designer-1407/Smart-Muscle/Photos/Smart Muscule 1/manufacturing_wiev.jpg

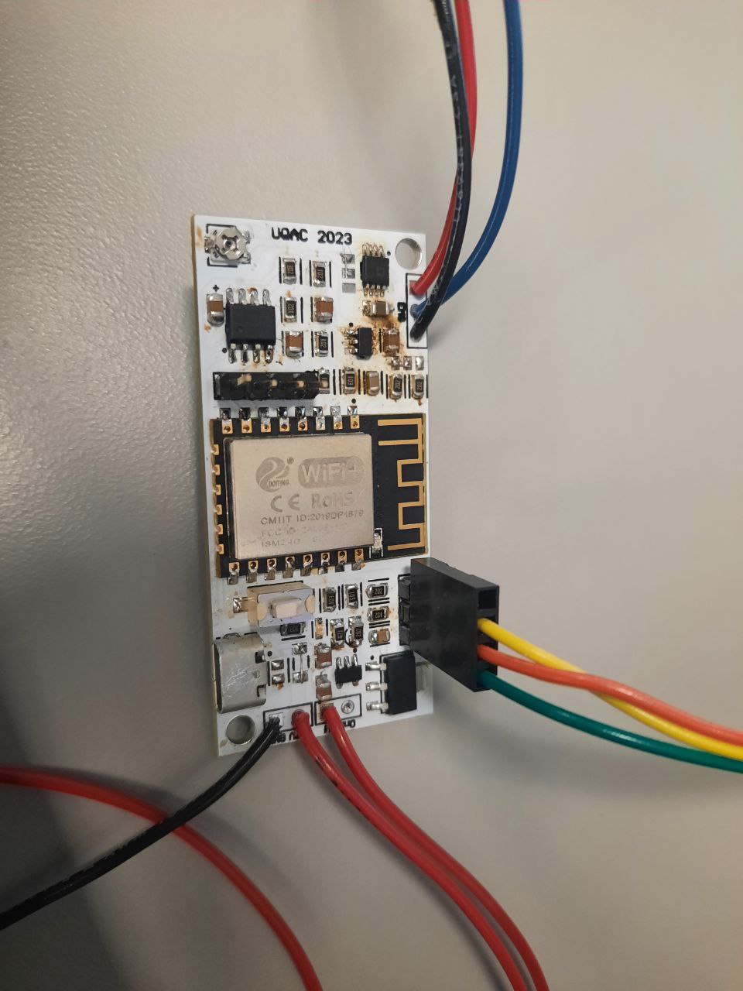
Photos/Smart Muscule 1/manufacturing_wiev.jpg
