designer-1407/Smart-Muscle/Photos/MyoWare Tests/Myoware.jpg

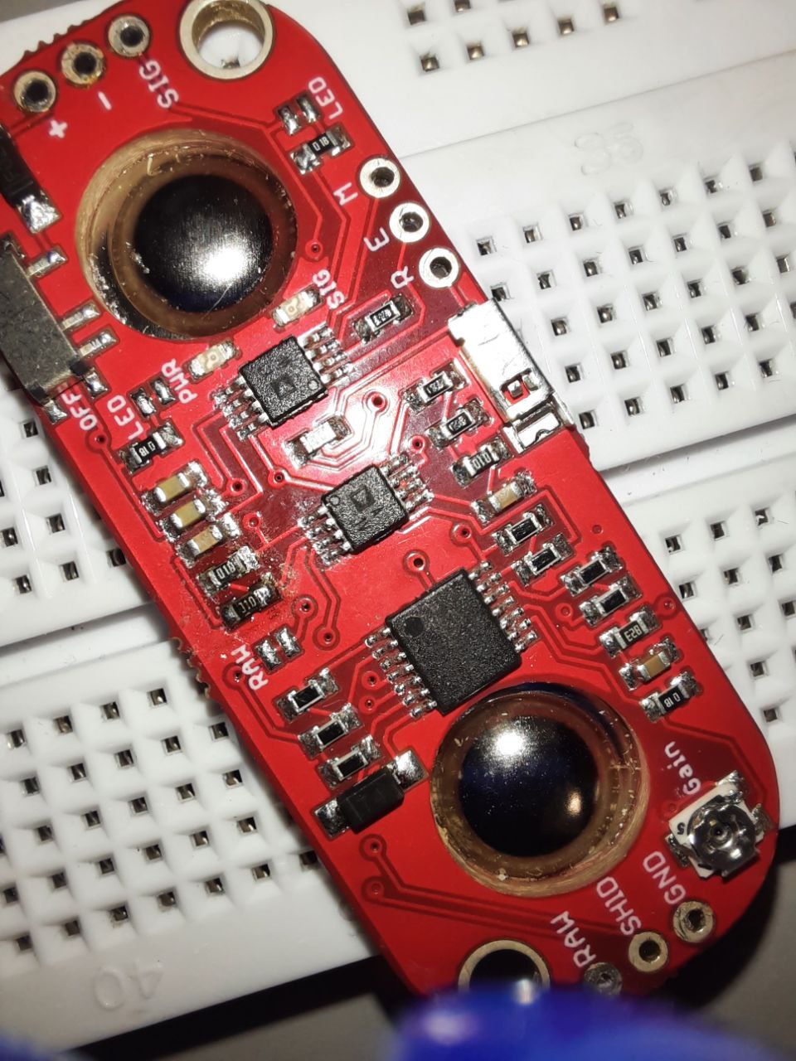
Photos/MyoWare Tests/Myoware.jpg
