designer-1407/Smart-Muscle/README.md

A SYSTEM FOR RECOGNIZING THE POSITION OF FINGERS OF AMPUTATED LIMBS BASED ON EMG SIGNAL AND MACHINE LEARNING
Studio_Project_V4 (1)
