designer-1407/Smart-Muscle/Photos/Smart Muscule 1/smart_muscule_case_1.jpg

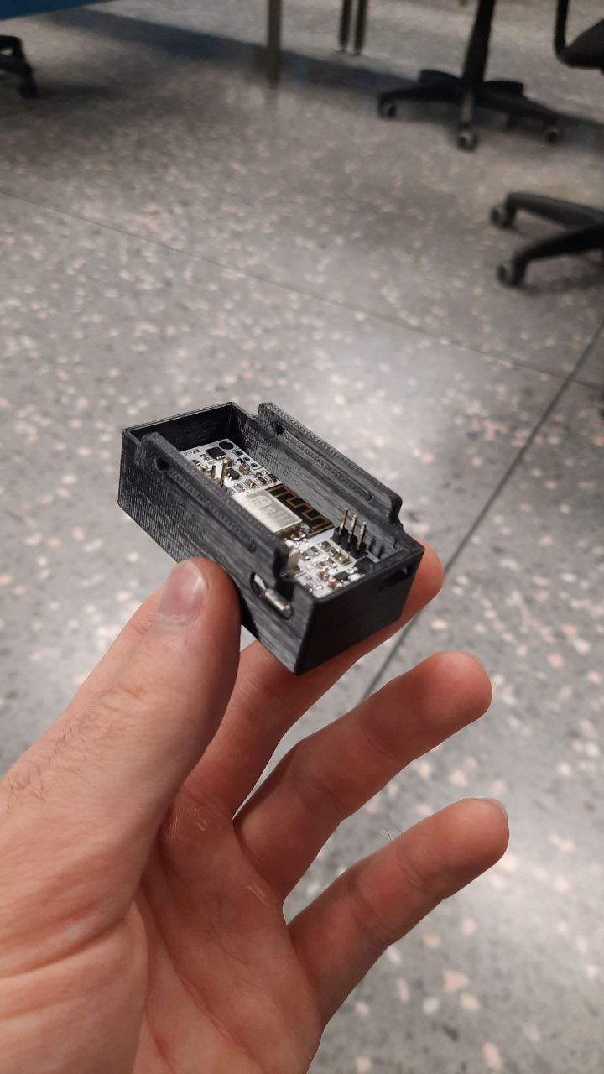
Photos/Smart Muscule 1/smart_muscule_case_1.jpg
