designer-1407/Smart-Muscle/Photos/Smart Muscule 1/smart_muscule_case_3D_wiev_2.jpg

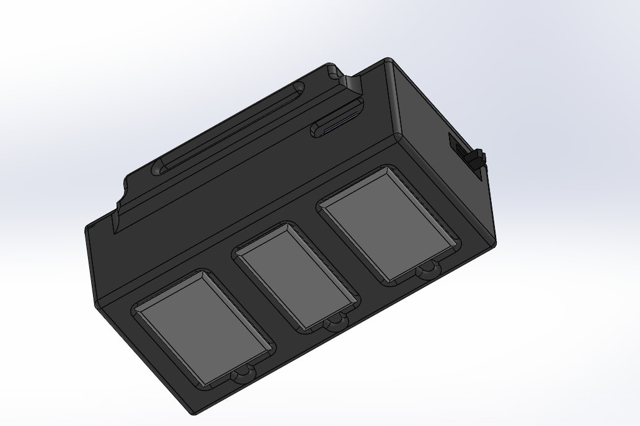
Photos/Smart Muscule 1/smart_muscule_case_3D_wiev_2.jpg
