designer-1407/Smart-Muscle/Photos/Smart Muscule 1/stainless_electrodes.jpg

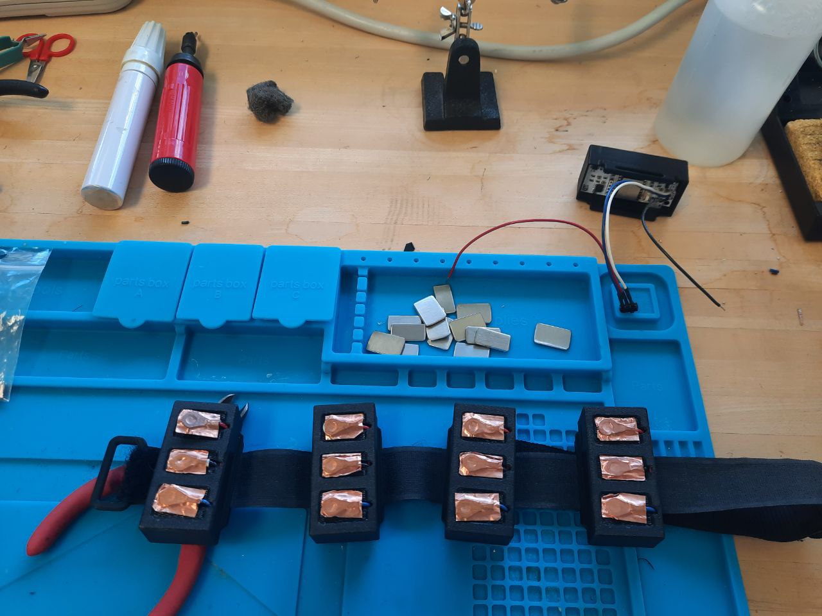
Photos/Smart Muscule 1/stainless_electrodes.jpg
