designer-1407/Smart-Muscle/Photos/Smart Muscule development/mock-up-1.jpg

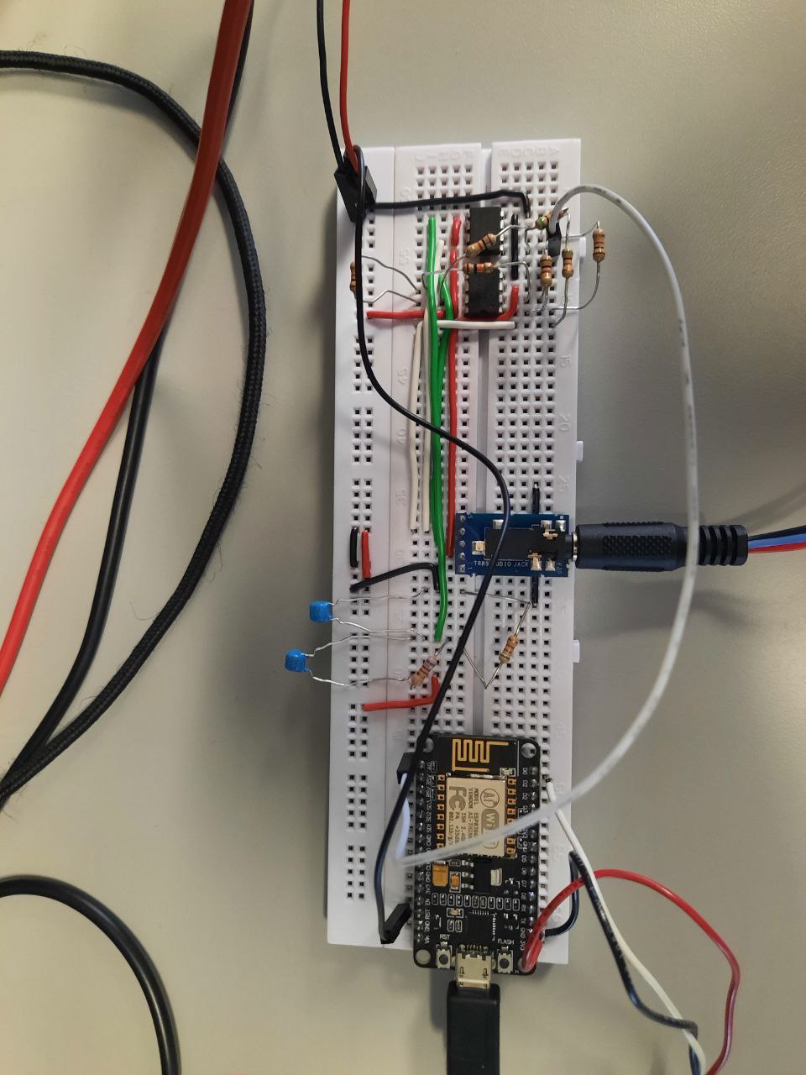
Photos/Smart Muscule development/mock-up-1.jpg
