designer-1407/Smart-Muscle/Scematics/Strct_scenatic.JPG

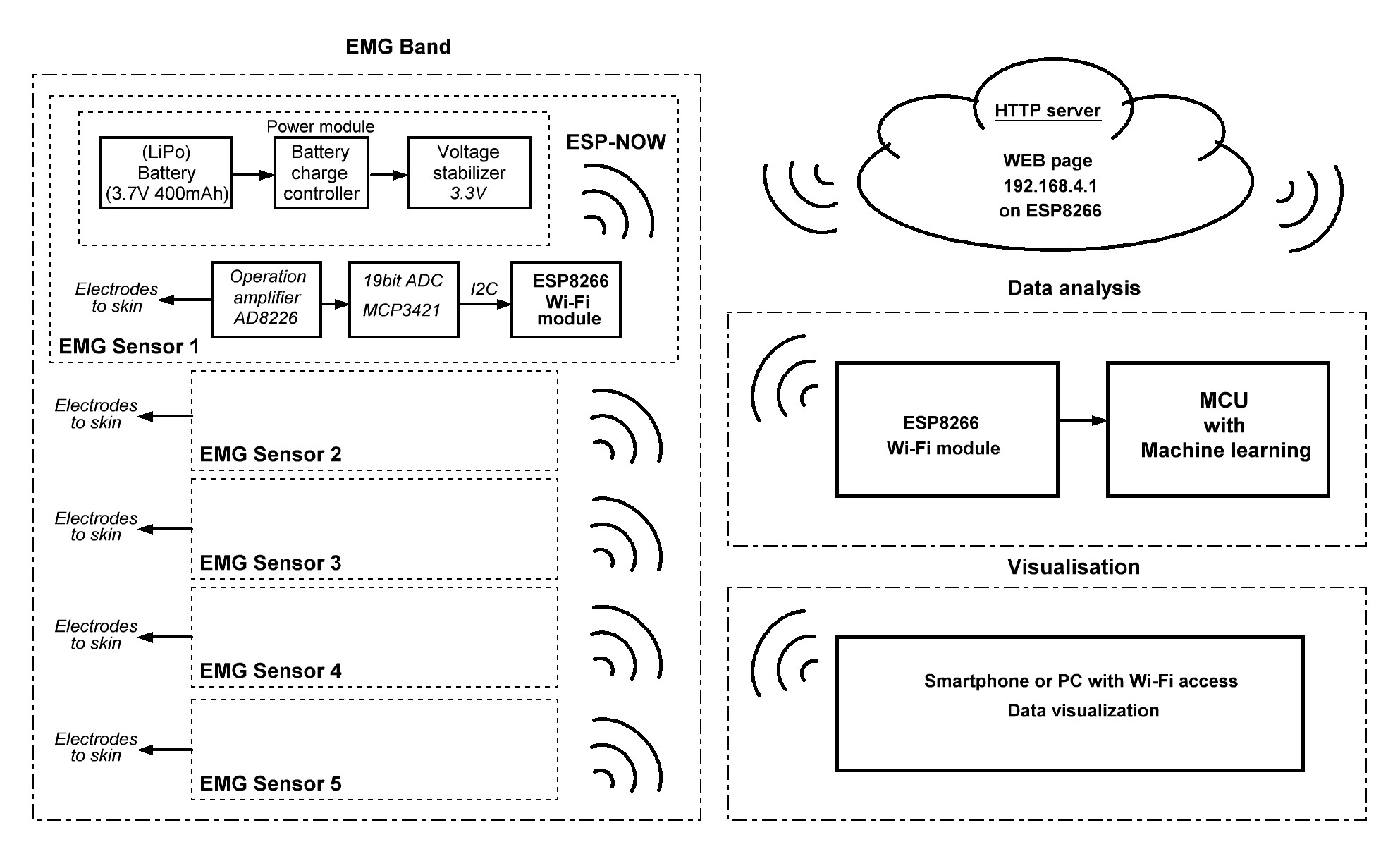
Scematics/Strct_scenatic.JPG
