designer-1407/Smart-Muscle/3D/top_1.SLDPRT

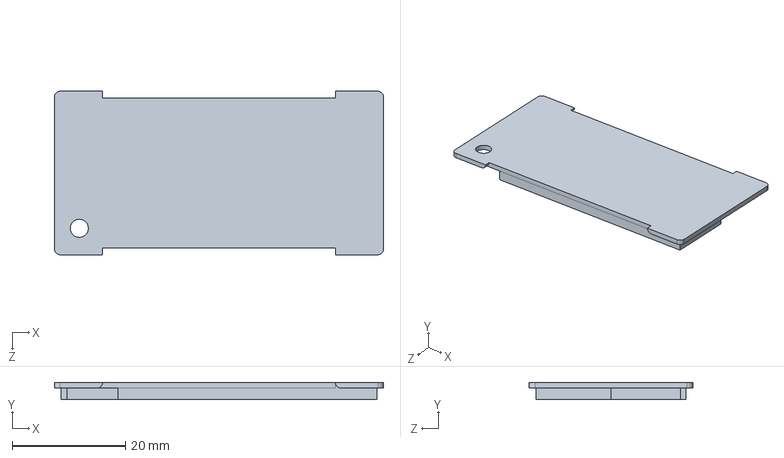
[picture p36: CAD file, 2023-08-23]
3D/top_1.SLDPRT
58.0 x 3.00 x 28.9 mm
