designer-1407/Smart-Muscle/3D/base_1.SLDPRT

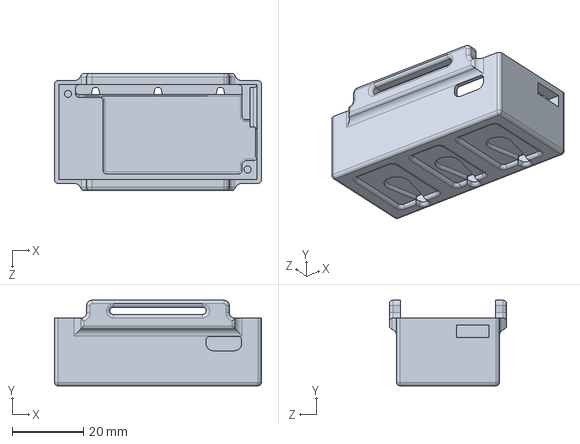
[picture p37: CAD file, 2023-08-23]
3D/base_1.SLDPRT
58.0 x 24.0 x 32.9 mm
