designer-1407/Smart-Muscle/(list of files, cad)

Other CAD files:
3D/base_1.STL
3D/top_1.STL
