designer-1407/Smart-Muscle/Photos/Smart Muscule 1/manufacturing_of_4_devices.jpg

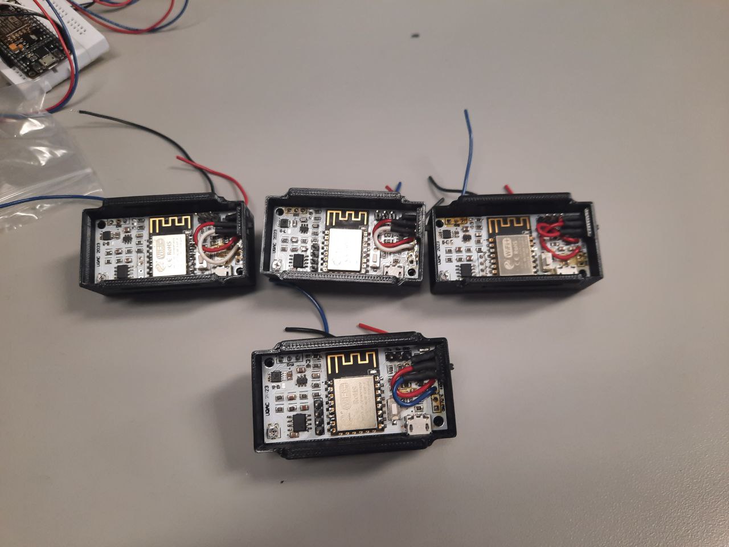
Photos/Smart Muscule 1/manufacturing_of_4_devices.jpg
