designer-1407/Smart-Muscle/Photos/Smart Muscule 1/me_in_soldering_process.jpg

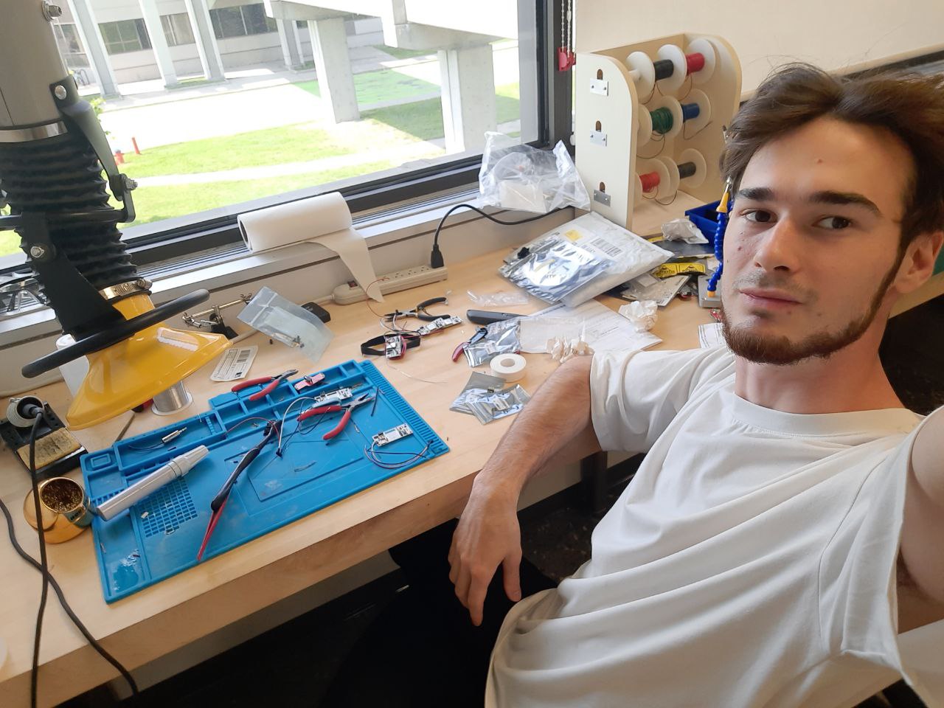
Photos/Smart Muscule 1/me_in_soldering_process.jpg
