designer-1407/Smart-Muscle/Photos/MyoWare Tests/data_from_myoware.jpg

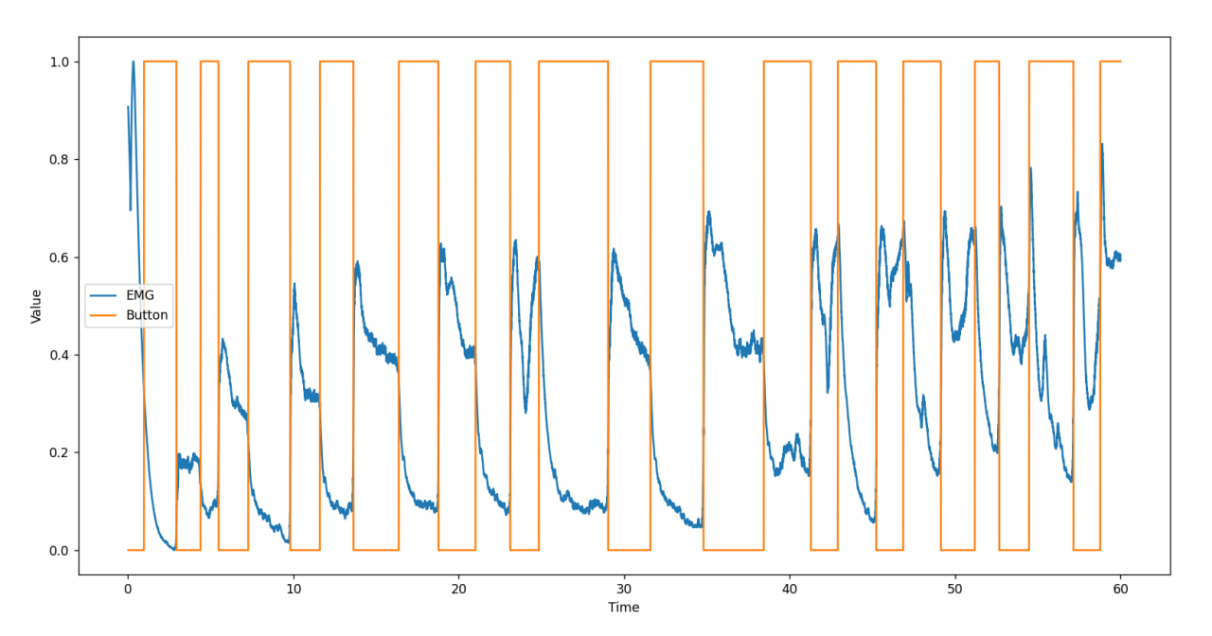
Photos/MyoWare Tests/data_from_myoware.jpg
