designer-1407/Smart-Muscle/Photos/MyoWare Tests/electrodes_hold_stand.jpg

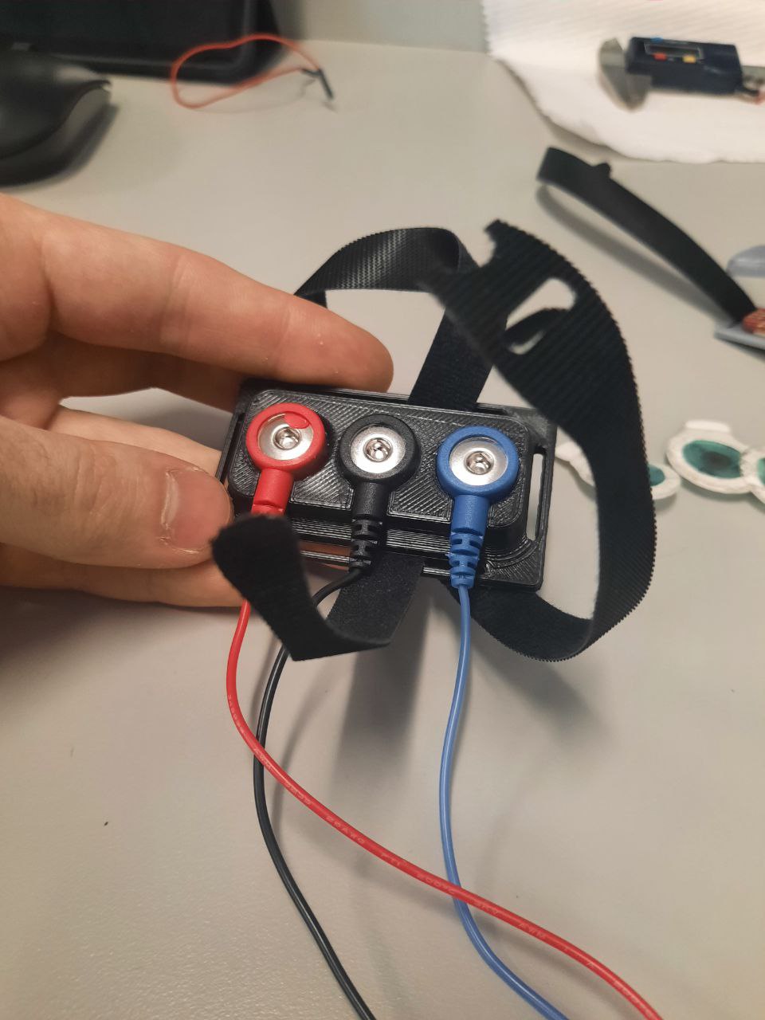
Photos/MyoWare Tests/electrodes_hold_stand.jpg
