designer-1407/Smart-Muscle/Photos/MyoWare Tests/ML_predictions.jpg

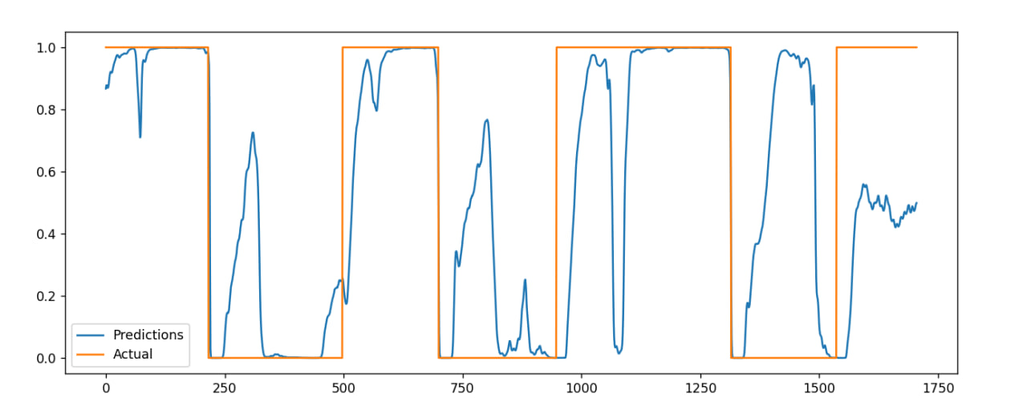
Photos/MyoWare Tests/ML_predictions.jpg
