designer-1407/Smart-Muscle/Photos/Smart Muscule development/mock-up-2-tests.jpg

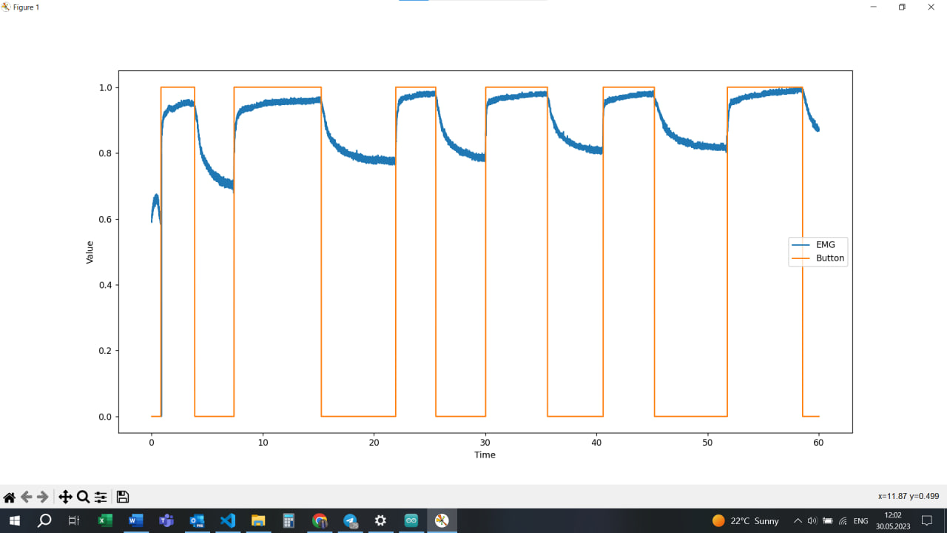
Photos/Smart Muscule development/mock-up-2-tests.jpg
