designer-1407/Smart-Muscle/Scematics/smart_muscle.pdf

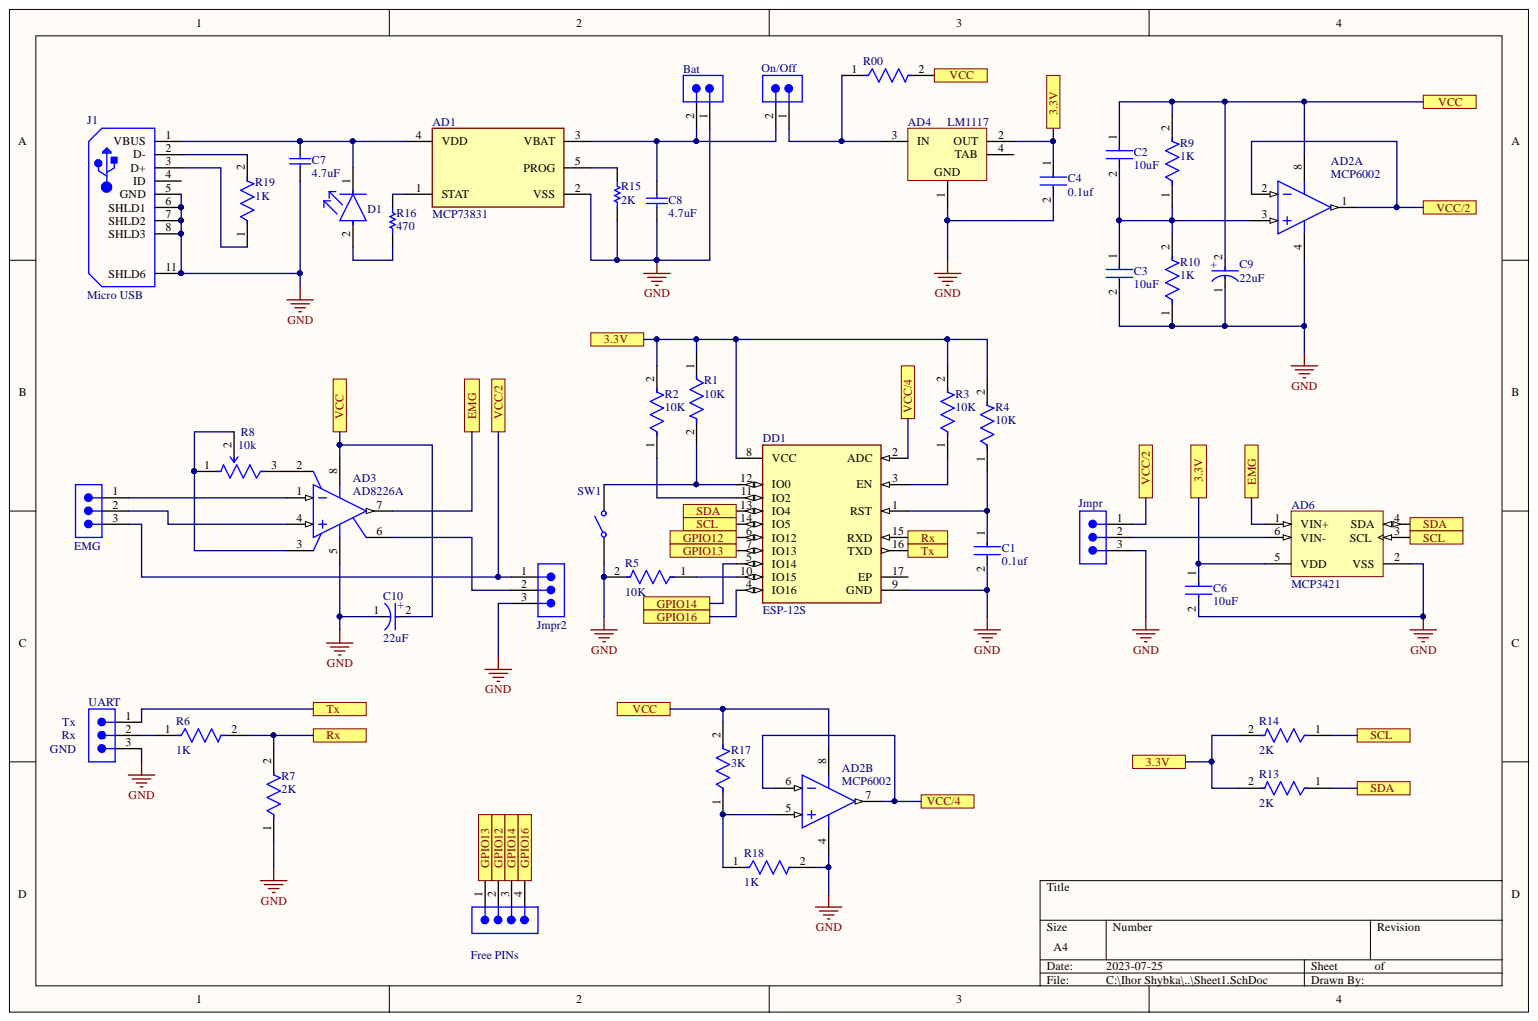
[picture p45: page 1]

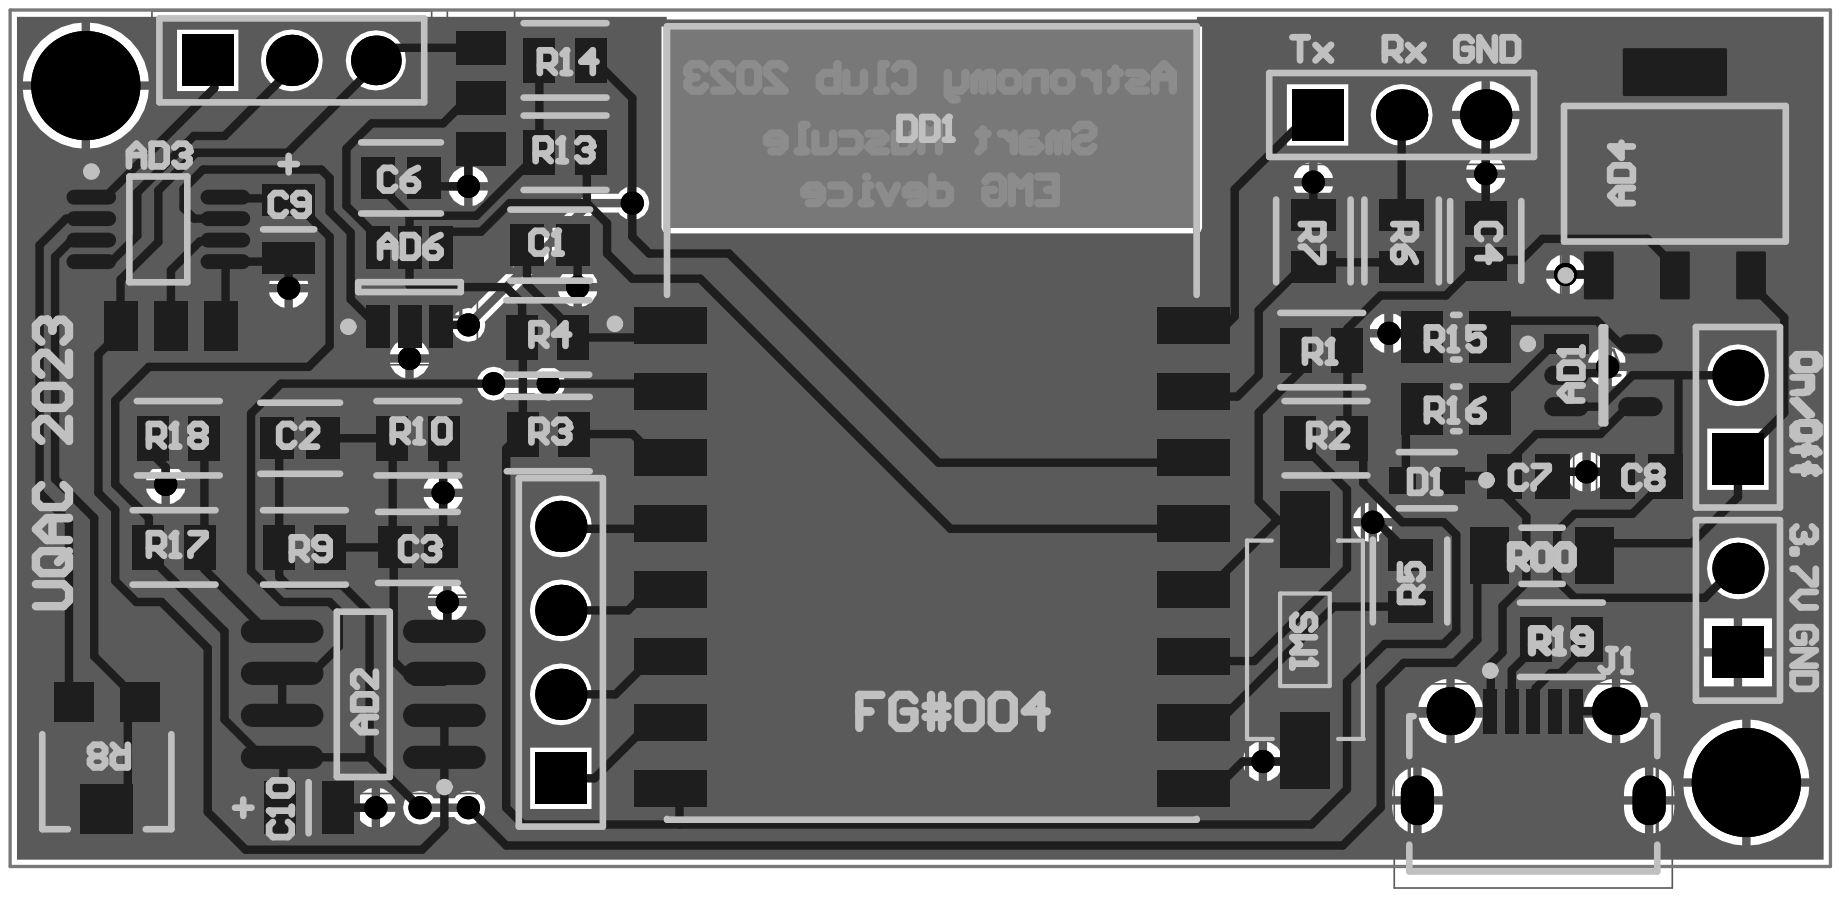
[picture p46: page 2]

# Board Stack Report
