designer-1407/Smart-Muscle/(list of files, drawings)

Other design files:
Scematics/smart_muscle/Copy of PCB1.PcbDoc
Scematics/smart_muscle/PCB1.PcbDoc
Scematics/smart_muscle/Sheet1.SchDoc
Scematics/smart_muscle/smart_muscle.PrjPcb
Scematics/smart_muscle/TP4056.PcbLib
Scematics/smart_muscle/tp4056.SchLib
