designer-1407/Smart-Muscle/(commit log)

2023-08-23 added schematics
    [Copy of PCB1.PcbDoc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]
2023-08-23 added photos with new electrodes
2023-08-23 I added schematics and software
    [base_1.SLDPRT, base_1.STL, top_1.SLDPRT, top_1.STL]
2023-08-23 readme for ESP code
    [PCB1.GBL, PCB1.GBO, PCB1.GBS, PCB1.GKO, PCB1.GTL, PCB1.GTO, PCB1.GTS]
